supermileage/fcp-control-pcb/fcp-control-pcb/Symbols/LM311DR/LM311DR.step

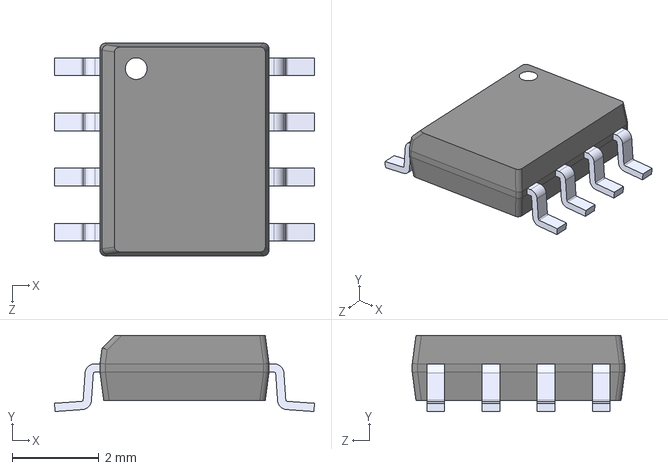
[picture p1: CAD file, 2022-12-03]
fcp-control-pcb/Symbols/LM311DR/LM311DR.step
5.99 x 1.75 x 4.90 mm
