supermileage/fcp-control-pcb/fcp-control-pcb/fcp-control-pcb.kicad_pcb

## KiCad design fcp-control-pcb/fcp-control-pcb.kicad_pcb (2023-03-18)

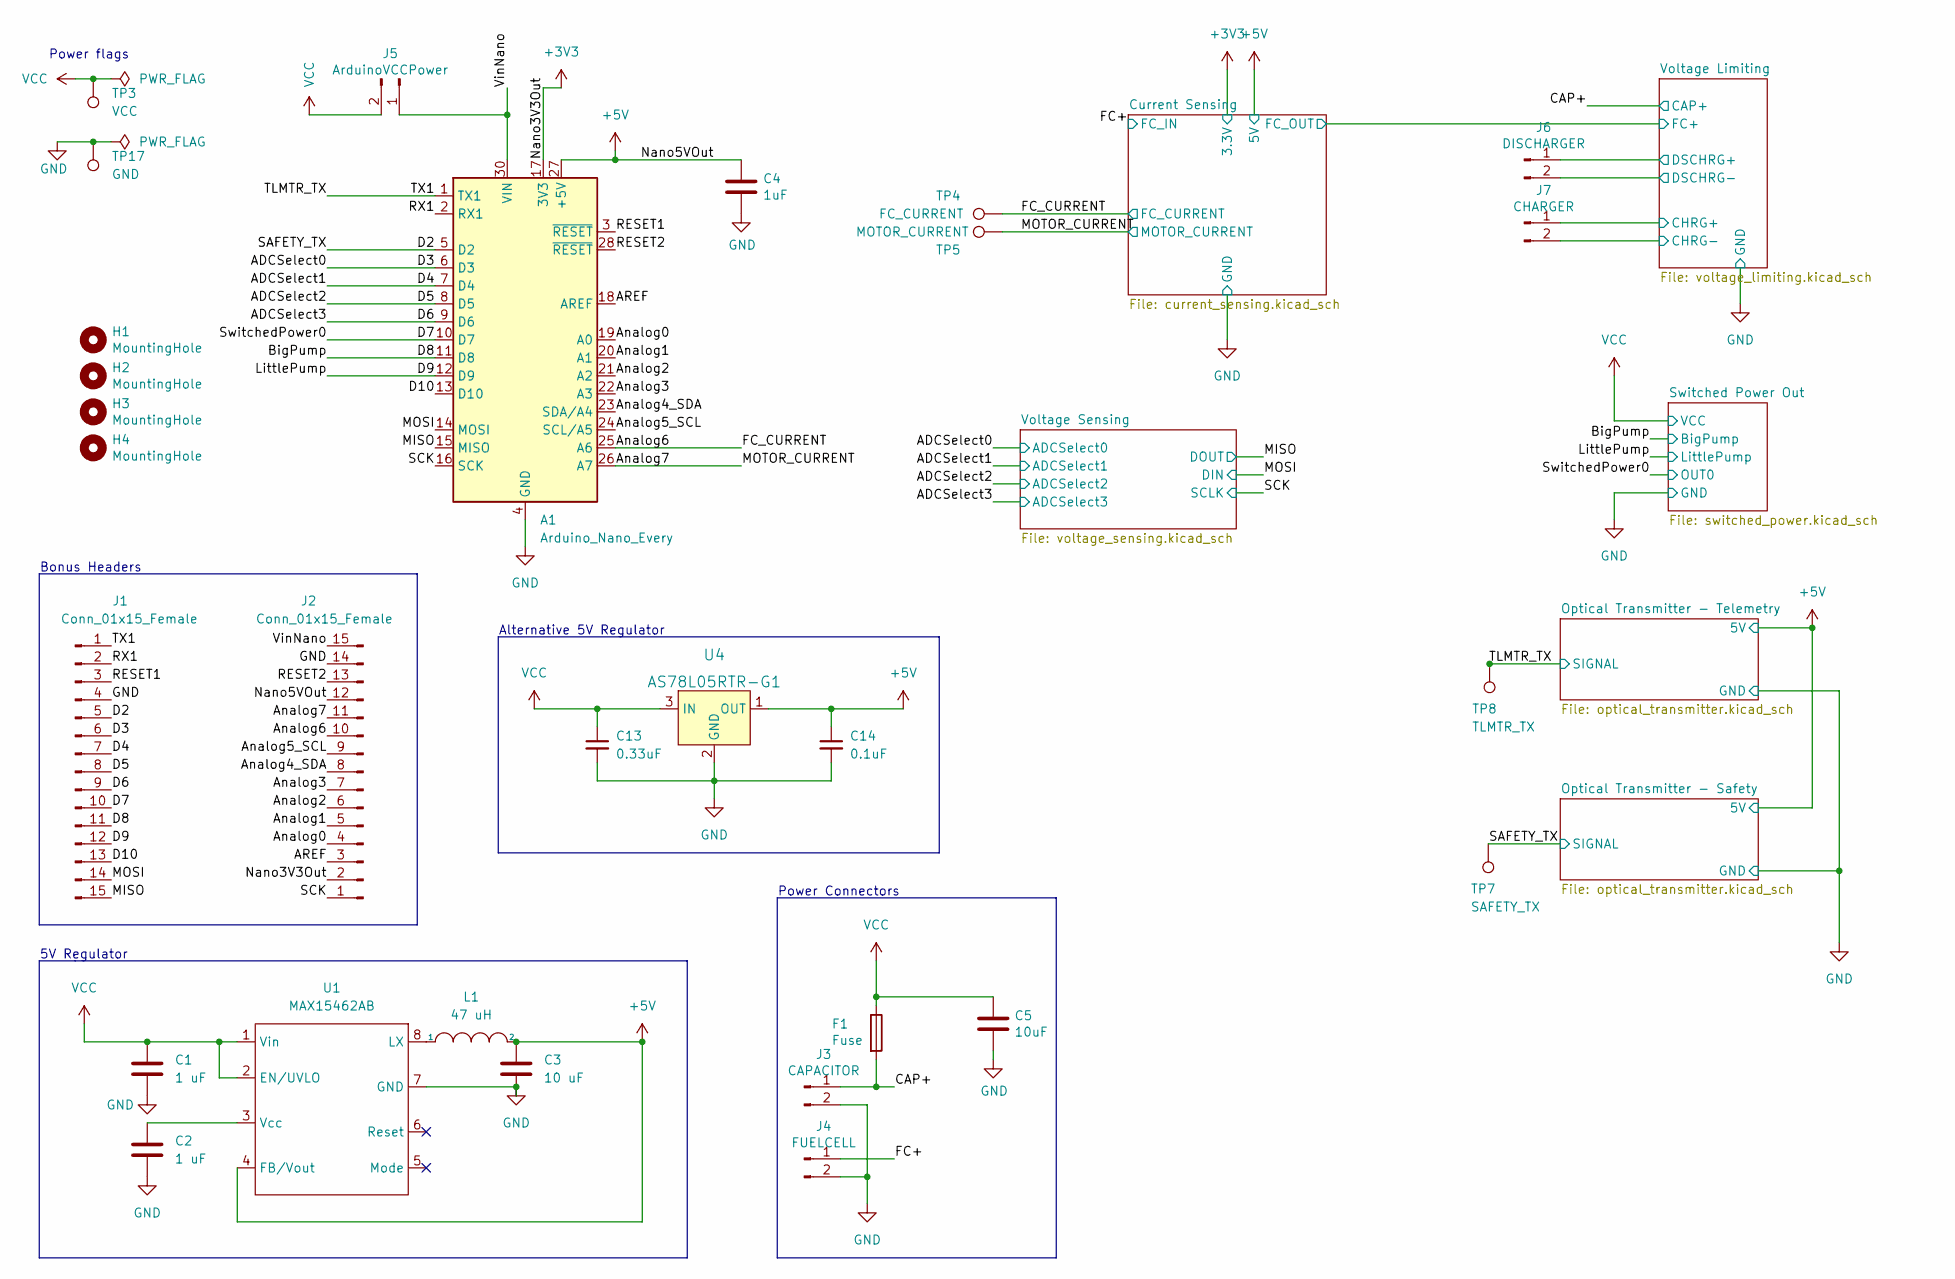
[picture p2: schematic fcp-control-pcb.kicad_sch]

Parts:
A1: Arduino_Nano_Every; Arduino_Nano
C1, C2: 1 uF; C_0805_2012Metric_Pad1.18x1.45mm_HandSolder
C3: 10 uF; C_0805_2012Metric_Pad1.18x1.45mm_HandSolder
C4: 1uF; C_0805_2012Metric_Pad1.18x1.45mm_HandSolder; DigikeyPN 490-12330-1-ND
C5: 10uF; C_0805_2012Metric_Pad1.18x1.45mm_HandSolder; DigikeyPN 490-12330-1-ND
C13: 0.33uF; C_0805_2012Metric_Pad1.18x1.45mm_HandSolder
C14: 0.1uF; C_0805_2012Metric_Pad1.18x1.45mm_HandSolder
F1: Fuse; 3586KTR; DigikeyPN 36-3586KCT-ND
H1, H2, H3, H4: MountingHole; MountingHole_3.2mm_M3
J1, J2: Conn_01x15_Female; PinSocket_1x15_P2.54mm_Vertical; MPN 310-87-115-41-001101; DigikeyPN 1212-1103-ND
J3: CAPACITOR; VP0265540000G
J4: FUELCELL; VP0265540000G; DigikeyPN VP0265540000G-ND
J5: ArduinoVCCPower; PinHeader_1x02_P2.54mm_Vertical
J6: DISCHARGER; Molex_Mini-Fit_Jr_5569-02A2_2x01_P4.20mm_Horizontal; DigikeyPN 0050361758-ND
J7: CHARGER; Molex_Mini-Fit_Jr_5569-02A2_2x01_P4.20mm_Horizontal; DigikeyPN 0050361758-ND
L1: 47 uH; L_Coilcraft_LPS4018
TP3: VCC; TestPoint_Pad_4.0x4.0mm
TP4: FC_CURRENT; TestPoint_Pad_4.0x4.0mm
TP5: MOTOR_CURRENT; TestPoint_Pad_4.0x4.0mm
TP7: SAFETY_TX; TestPoint_Pad_4.0x4.0mm
TP8: TLMTR_TX; TestPoint_Pad_4.0x4.0mm
TP17: GND; TestPoint_Pad_4.0x4.0mm
U1: MAX15462AB; TDFN-8-1EP_2x2mm_P0.5mm_EP0.8x1.2mm; digikey part no. MAX15462BATA+TCT-ND
U4: AS78L05RTR-G1; SOT-89-3_Handsoldering; MPN AS78L05RTR-G1; Digi-Key_PN AS78L05RTR-G1DITR-ND

Connections:
+3V3: A1.17 (3V3), J2.2; also elsewhere on the board
+5V: A1.27 (+5V), C3.1, C4.1, C14.1, J2.12, L1.2, U1.4 (FB/Vout), U4.1 (OUT); also elsewhere on the board
/ADCSelect0: A1.6 (D3), J1.6; also elsewhere on the board
/ADCSelect1: A1.7 (D4), J1.7; also elsewhere on the board
/ADCSelect2: A1.8 (D5), J1.8; also elsewhere on the board
/ADCSelect3: A1.9 (D6), J1.9; also elsewhere on the board
/AREF: A1.18 (AREF), J2.3
/Analog0: A1.19 (A0), J2.4
/Analog1: A1.20 (A1), J2.5
/Analog2: A1.21 (A2), J2.6
/Analog3: A1.22 (A3), J2.7
/Analog4_SDA: A1.23 (SDA/A4), J2.8
/Analog5_SCL: A1.24 (SCL/A5), J2.9
/Analog6: A1.25 (A6), J2.10, TP4.1; also elsewhere on the board
/Analog7: A1.26 (A7), J2.11, TP5.1; also elsewhere on the board
/BigPump: A1.11 (D8), J1.11; also elsewhere on the board
/CAP+: F1.2, J3.1; also elsewhere on the board
/D2: A1.5 (D2), J1.5, TP7.1; also elsewhere on the board
/D7: A1.10 (D7), J1.10; also elsewhere on the board
/D9: A1.12 (D9), J1.12; also elsewhere on the board
/D10: A1.13 (D10), J1.13
/FC+: J4.1; also elsewhere on the board
/MISO: A1.15 (MISO), J1.15; also elsewhere on the board
/MOSI: A1.14 (MOSI), J1.14; also elsewhere on the board
/RESET1: A1.3 (~RESET), J1.3
/RESET2: A1.28 (~RESET), J2.13
/RX1: A1.2 (RX1), J1.2
/SCK: A1.16 (SCK), J2.1; also elsewhere on the board
/TLMTR_TX: A1.1 (TX1), J1.1, TP8.1; also elsewhere on the board
/VinNano: A1.30 (VIN), J2.15, J5.1
/Voltage Limiting/CHRG+: J7.1; also elsewhere on the board
/Voltage Limiting/DSCHRG+: J6.1; also elsewhere on the board
GND: A1.4 (GND), A1.29 (GND), C1.2, C2.2, C3.2, C4.2, C5.2, C13.2, C14.2, J1.4, J2.14, J3.2, J4.2, J6.2, J7.2, TP17.1, U1.7 (GND), U4.2 (GND); also elsewhere on the board
unnamed: C2.1, U1.3 (Vcc)
unnamed: L1.1, U1.8 (LX)
VCC: C1.1, C5.1, C13.1, F1.1, J5.2, TP3.1, U1.1 (Vin), U1.2 (EN/UVLO), U4.3 (IN); also elsewhere on the board

Notes on the sheet:
5V Regulator
Power Connectors
Power flags
Bonus Headers
Alternative 5V Regulator

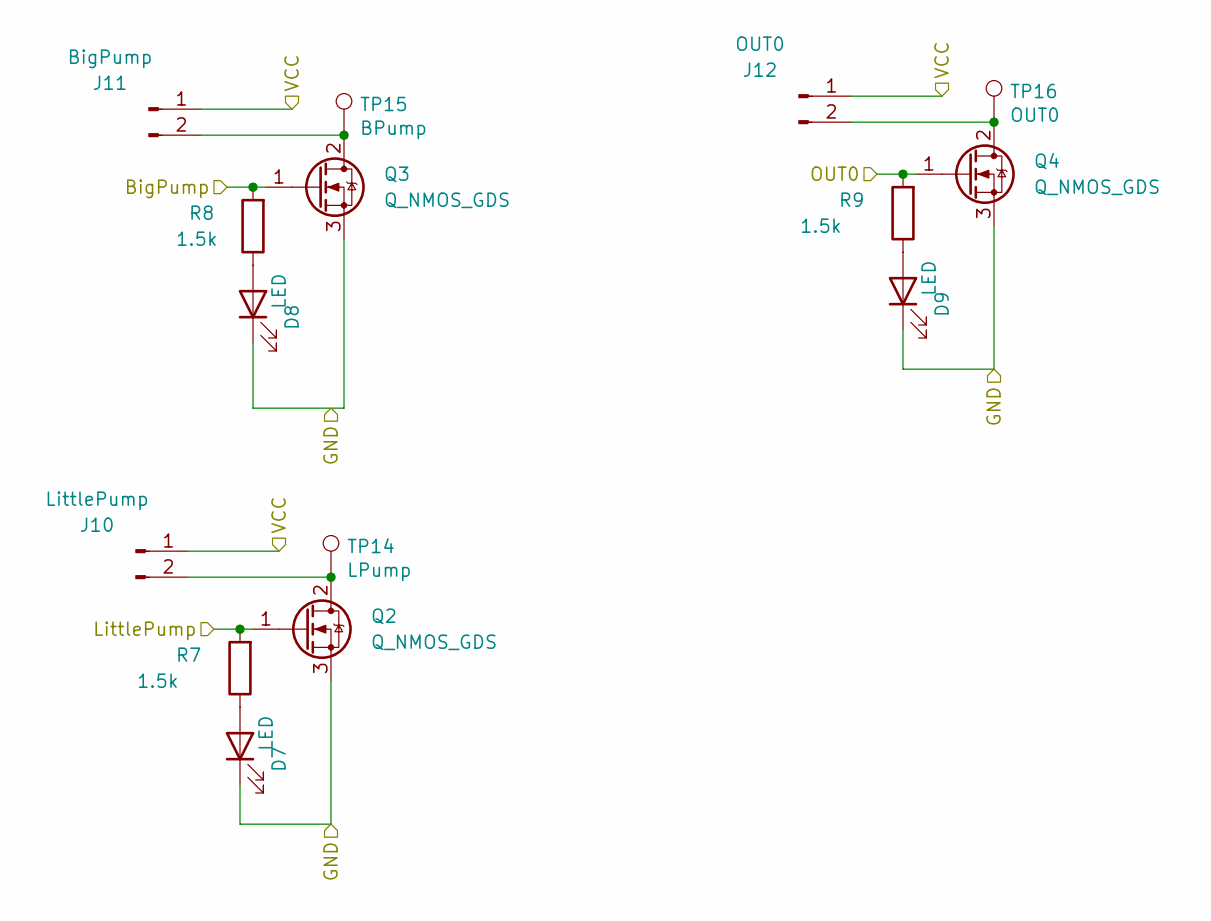
[picture p3: schematic switched_power.kicad_sch]

Parts:
D7, D8, D9: LED; LED_0603_1608Metric; DigikeyPN SML-D12W8WT86ACT-ND
J10: LittlePump; Molex_Mini-Fit_Jr_5569-02A2_2x01_P4.20mm_Horizontal; DigikeyPN 0050361758-ND
J11: BigPump; Molex_Mini-Fit_Jr_5569-02A2_2x01_P4.20mm_Horizontal; DigikeyPN 0050361758-ND
J12: OUT0; Molex_Mini-Fit_Jr_5569-02A2_2x01_P4.20mm_Horizontal; DigikeyPN 0050361758-ND
Q2, Q3, Q4: Q_NMOS_GDS; SOT-89-3_Handsoldering; DigikeyPN DMN2004WKDICT-ND
R7, R8, R9: 1.5k; R_0805_2012Metric_Pad1.20x1.40mm_HandSolder; DigikeyPN A121524CT-ND
TP14: LPump; PinSocket_1x01_P2.54mm_Vertical
TP15: BPump; PinSocket_1x01_P2.54mm_Vertical
TP16: OUT0; PinSocket_1x01_P2.54mm_Vertical

Connections:
/BigPump: Q3.1 (G), R8.2; also elsewhere on the board
/D7: Q4.1 (G), R9.2; also elsewhere on the board
/D9: Q2.1 (G), R7.2; also elsewhere on the board
GND: D7.1 (K), D8.1 (K), D9.1 (K), Q2.3 (S), Q3.3 (S), Q4.3 (S); also elsewhere on the board
unnamed: D7.2 (A), R7.1
unnamed: D8.2 (A), R8.1
unnamed: D9.2 (A), R9.1
unnamed: J10.2, Q2.2 (D), TP14.1
unnamed: J11.2, Q3.2 (D), TP15.1
unnamed: J12.2, Q4.2 (D), TP16.1
VCC: J10.1, J11.1, J12.1; also elsewhere on the board

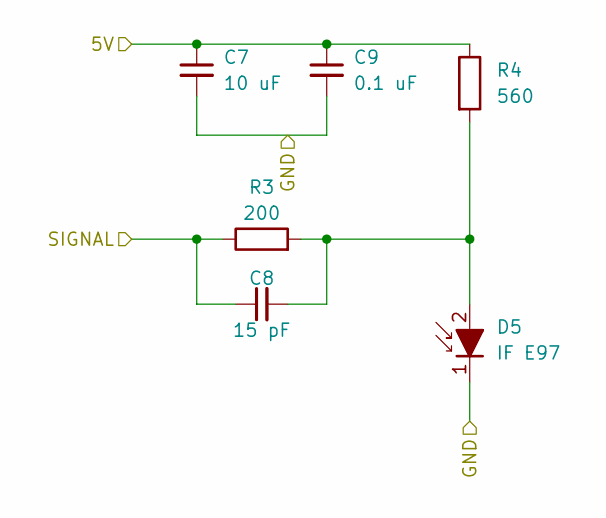
[picture p4: schematic optical_transmitter.kicad_sch]

Parts:
C7: 10 uF; C_0805_2012Metric_Pad1.18x1.45mm_HandSolder
C8: 15 pF; C_0805_2012Metric_Pad1.18x1.45mm_HandSolder
C9: 0.1 uF; C_0805_2012Metric_Pad1.18x1.45mm_HandSolder
D5: IF E97; IF-E97
R3: 200; R_0805_2012Metric_Pad1.20x1.40mm_HandSolder
R4: 560; R_0805_2012Metric_Pad1.20x1.40mm_HandSolder

Connections:
+5V: C7.1, C9.1, R4.1; also elsewhere on the board
/TLMTR_TX: C8.1, R3.1; also elsewhere on the board
GND: C7.2, C9.2, D5.1 (K); also elsewhere on the board
unnamed: C8.2, D5.2 (A), R3.2, R4.2

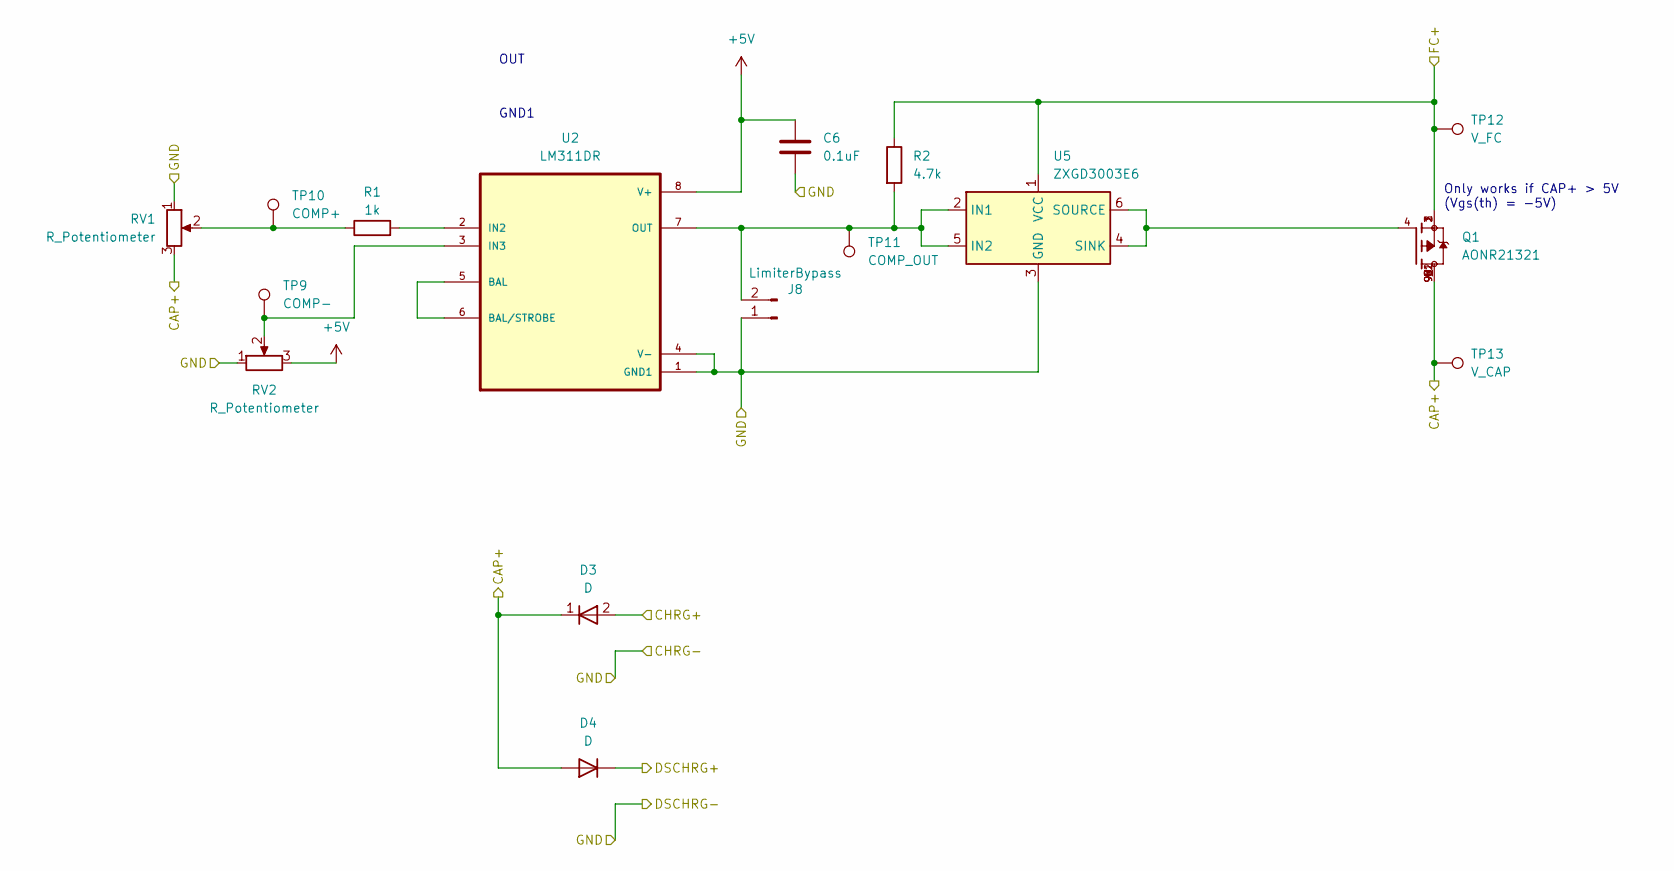
[picture p5: schematic voltage_limiting.kicad_sch]

Parts:
C6: 0.1uF; C_0805_2012Metric_Pad1.18x1.45mm_HandSolder
D3, D4: D; D_PowerDI-5
J8: LimiterBypass; PinHeader_1x02_P2.54mm_Vertical; DigikeyPN 0050361758-ND
Q1: AONR21321; TRANS_AONR21321; PARTREV 1.0
R1: 1k; R_0805_2012Metric_Pad1.20x1.40mm_HandSolder
R2: 4.7k; R_0805_2012Metric_Pad1.20x1.40mm_HandSolder
RV1, RV2: R_Potentiometer; TRIM_3361P-1-203GLF
TP9: COMP-; TestPoint_Pad_4.0x4.0mm
TP10: COMP+; TestPoint_Pad_4.0x4.0mm
TP11: COMP_OUT; TestPoint_Pad_4.0x4.0mm
TP12: V_FC; TestPoint_Pad_4.0x4.0mm
TP13: V_CAP; TestPoint_Pad_4.0x4.0mm
U2: LM311DR; SOIC127P599X175-8N
U5: ZXGD3003E6; SOT-23-6

Connections:
+5V: C6.1, RV2.3, U2.8 (V+); also elsewhere on the board
/CAP+: D3.1 (K), D4.2 (A), Q1.5, Q1.6, Q1.7, Q1.8, Q1.9, Q1.9_1, Q1.9_2, RV1.3, TP13.1; also elsewhere on the board
/Current Sensing/FC_OUT: Q1.1, Q1.2, Q1.3, R2.1, TP12.1, U5.1 (VCC); also elsewhere on the board
/Voltage Limiting/CHRG+: D3.2 (A); also elsewhere on the board
/Voltage Limiting/DSCHRG+: D4.1 (K); also elsewhere on the board
GND: C6.2, J8.1, RV1.1, RV2.1, U2.1 (GND1), U2.4 (V-), U5.3 (GND); also elsewhere on the board
unnamed: J8.2, R2.2, TP11.1, U2.7 (OUT), U5.2 (IN1), U5.5 (IN2)
unnamed: Q1.4, U5.4 (SINK), U5.6 (SOURCE)
unnamed: R1.1, RV1.2, TP10.1
unnamed: R1.2, U2.2 (IN2)
unnamed: RV2.2, TP9.1, U2.3 (IN3)
unnamed: U2.5 (BAL), U2.6 (BAL/STROBE)

Notes on the sheet:
OUT
GND1
Only works if CAP+ > 5V (Vgs(th) = -5V)

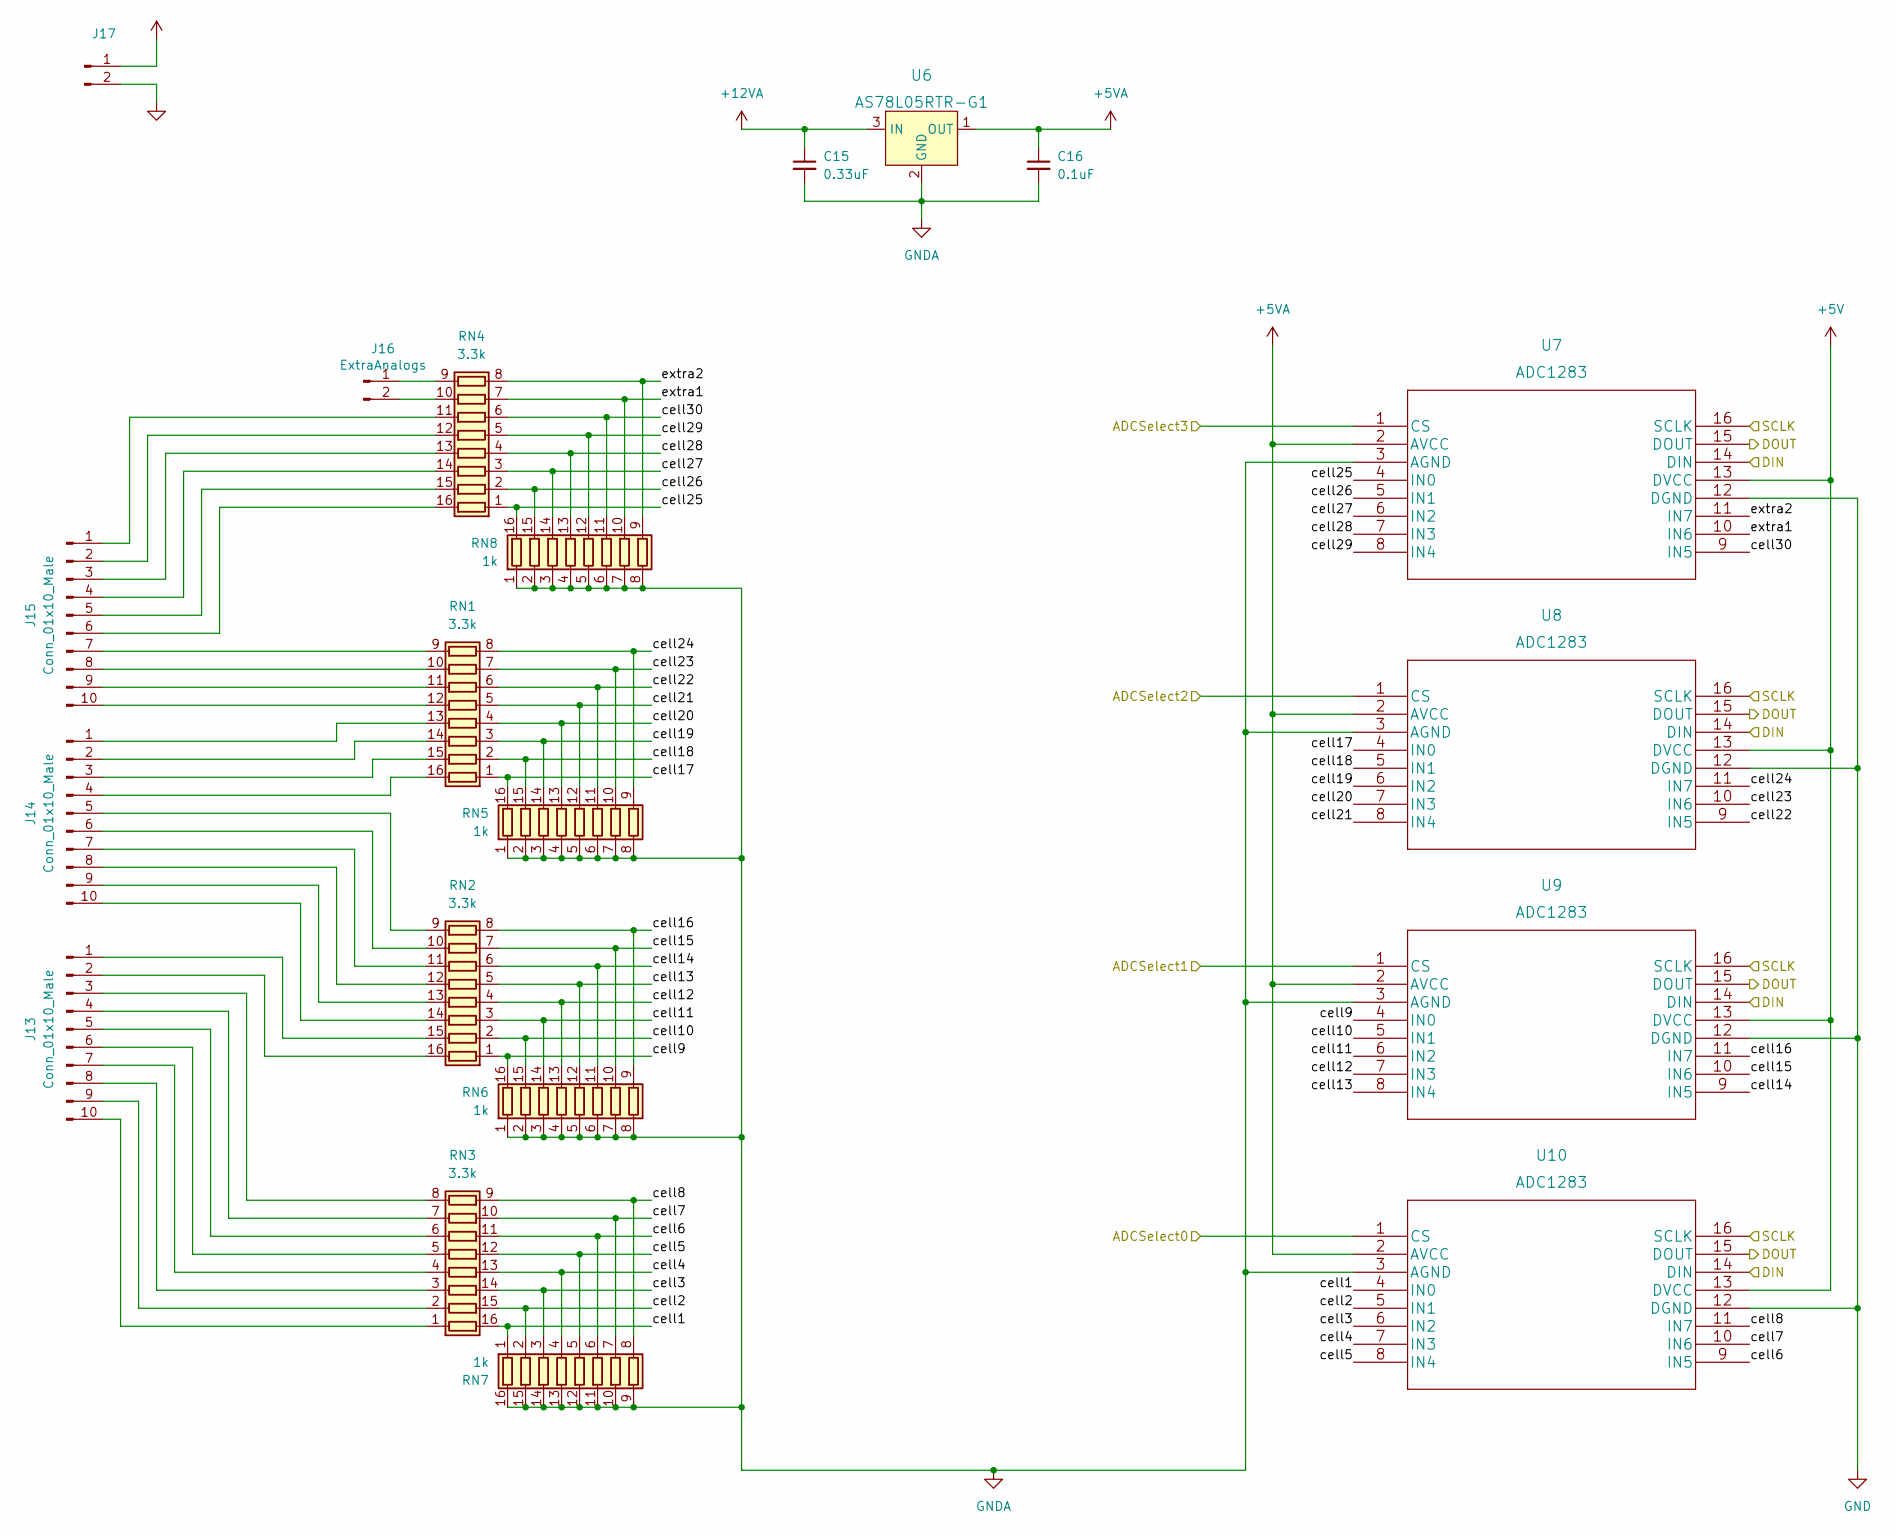
[picture p6: schematic voltage_sensing.kicad_sch]

Parts:
C15: 0.33uF; C_0805_2012Metric_Pad1.18x1.45mm_HandSolder
C16: 0.1uF; C_0805_2012Metric_Pad1.18x1.45mm_HandSolder
J13, J14, J15: Conn_01x10_Male; PhoenixContact_MCV_1,5_10-G-3.5_1x10_P3.50mm_Vertical; DigikeyPN 277-5774-ND
J16: ExtraAnalogs; PinHeader_1x02_P2.54mm_Vertical
J17: DigikeyPN 0050361758-ND
RN1, RN2, RN3, RN4: 3.3k; SOIC-16_4.55x10.3mm_P1.27mm
RN5, RN6, RN7, RN8: 1k; SOIC-16_4.55x10.3mm_P1.27mm
U6: AS78L05RTR-G1; SOT-89-3_Handsoldering; MPN AS78L05RTR-G1; Digi-Key_PN AS78L05RTR-G1DITR-ND
U7, U8, U9, U10: ADC1283; TSSOP-16_4.4x5mm_P0.65mm

Connections:
+5V: U7.13 (DVCC), U8.13 (DVCC), U9.13 (DVCC), U10.13 (DVCC); also elsewhere on the board
+5VA: C16.1, U6.1 (OUT), U7.2 (AVCC), U8.2 (AVCC), U9.2 (AVCC), U10.2 (AVCC)
/ADCSelect0: U10.1 (CS); also elsewhere on the board
/ADCSelect1: U9.1 (CS); also elsewhere on the board
/ADCSelect2: U8.1 (CS); also elsewhere on the board
/ADCSelect3: U7.1 (CS); also elsewhere on the board
/MISO: U7.15 (DOUT), U8.15 (DOUT), U9.15 (DOUT), U10.15 (DOUT); also elsewhere on the board
/MOSI: U7.14 (DIN), U8.14 (DIN), U9.14 (DIN), U10.14 (DIN); also elsewhere on the board
/SCK: U7.16 (SCLK), U8.16 (SCLK), U9.16 (SCLK), U10.16 (SCLK); also elsewhere on the board
/Voltage Sensing/cell1: RN3.16 (R1.2), RN7.1 (R1.1), U10.4 (IN0)
/Voltage Sensing/cell2: RN3.15 (R2.2), RN7.2 (R2.1), U10.5 (IN1)
/Voltage Sensing/cell3: RN3.14 (R3.2), RN7.3 (R3.1), U10.6 (IN2)
/Voltage Sensing/cell4: RN3.13 (R4.2), RN7.4 (R4.1), U10.7 (IN3)
/Voltage Sensing/cell5: RN3.12 (R5.2), RN7.5 (R5.1), U10.8 (IN4)
/Voltage Sensing/cell6: RN3.11 (R6.2), RN7.6 (R6.1), U10.9 (IN5)
/Voltage Sensing/cell7: RN3.10 (R7.2), RN7.7 (R7.1), U10.10 (IN6)
/Voltage Sensing/cell8: RN3.9 (R8.2), RN7.8 (R8.1), U10.11 (IN7)
/Voltage Sensing/cell9: RN2.1 (R1.1), RN6.16 (R1.2), U9.4 (IN0)
/Voltage Sensing/cell10: RN2.2 (R2.1), RN6.15 (R2.2), U9.5 (IN1)
/Voltage Sensing/cell11: RN2.3 (R3.1), RN6.14 (R3.2), U9.6 (IN2)
/Voltage Sensing/cell12: RN2.4 (R4.1), RN6.13 (R4.2), U9.7 (IN3)
/Voltage Sensing/cell13: RN2.5 (R5.1), RN6.12 (R5.2), U9.8 (IN4)
/Voltage Sensing/cell14: RN2.6 (R6.1), RN6.11 (R6.2), U9.9 (IN5)
/Voltage Sensing/cell15: RN2.7 (R7.1), RN6.10 (R7.2), U9.10 (IN6)
/Voltage Sensing/cell16: RN2.8 (R8.1), RN6.9 (R8.2), U9.11 (IN7)
/Voltage Sensing/cell17: RN1.1 (R1.1), RN5.16 (R1.2), U8.4 (IN0)
/Voltage Sensing/cell18: RN1.2 (R2.1), RN5.15 (R2.2), U8.5 (IN1)
/Voltage Sensing/cell19: RN1.3 (R3.1), RN5.14 (R3.2), U8.6 (IN2)
/Voltage Sensing/cell20: RN1.4 (R4.1), RN5.13 (R4.2), U8.7 (IN3)
/Voltage Sensing/cell21: RN1.5 (R5.1), RN5.12 (R5.2), U8.8 (IN4)
/Voltage Sensing/cell22: RN1.6 (R6.1), RN5.11 (R6.2), U8.9 (IN5)
/Voltage Sensing/cell23: RN1.7 (R7.1), RN5.10 (R7.2), U8.10 (IN6)
/Voltage Sensing/cell24: RN1.8 (R8.1), RN5.9 (R8.2), U8.11 (IN7)
/Voltage Sensing/cell25: RN4.1 (R1.1), RN8.16 (R1.2), U7.4 (IN0)
/Voltage Sensing/cell26: RN4.2 (R2.1), RN8.15 (R2.2), U7.5 (IN1)
/Voltage Sensing/cell27: RN4.3 (R3.1), RN8.14 (R3.2), U7.6 (IN2)
/Voltage Sensing/cell28: RN4.4 (R4.1), RN8.13 (R4.2), U7.7 (IN3)
/Voltage Sensing/cell29: RN4.5 (R5.1), RN8.12 (R5.2), U7.8 (IN4)
/Voltage Sensing/cell30: RN4.6 (R6.1), RN8.11 (R6.2), U7.9 (IN5)
/Voltage Sensing/extra1: RN4.7 (R7.1), RN8.10 (R7.2), U7.10 (IN6)
/Voltage Sensing/extra2: RN4.8 (R8.1), RN8.9 (R8.2), U7.11 (IN7)
GND: U7.12 (DGND), U8.12 (DGND), U9.12 (DGND), U10.12 (DGND); also elsewhere on the board
unnamed: J13.1, RN2.15 (R2.2)
unnamed: J13.2, RN2.16 (R1.2)
unnamed: J13.3, RN3.8 (R8.1)
unnamed: J13.4, RN3.7 (R7.1)
unnamed: J13.5, RN3.6 (R6.1)
unnamed: J13.6, RN3.5 (R5.1)
unnamed: J13.7, RN3.4 (R4.1)
unnamed: J13.8, RN3.3 (R3.1)
unnamed: J13.9, RN3.2 (R2.1)
unnamed: J13.10, RN3.1 (R1.1)
unnamed: J14.1, RN1.13 (R4.2)
unnamed: J14.2, RN1.14 (R3.2)
unnamed: J14.3, RN1.15 (R2.2)
unnamed: J14.4, RN1.16 (R1.2)
unnamed: J14.5, RN2.9 (R8.2)
unnamed: J14.6, RN2.10 (R7.2)
unnamed: J14.7, RN2.11 (R6.2)
unnamed: J14.8, RN2.12 (R5.2)
unnamed: J14.9, RN2.13 (R4.2)
unnamed: J14.10, RN2.14 (R3.2)
unnamed: J15.1, RN4.11 (R6.2)
unnamed: J15.2, RN4.12 (R5.2)
unnamed: J15.3, RN4.13 (R4.2)
unnamed: J15.4, RN4.14 (R3.2)
unnamed: J15.5, RN4.15 (R2.2)
unnamed: J15.6, RN4.16 (R1.2)
unnamed: J15.7, RN1.9 (R8.2)
unnamed: J15.8, RN1.10 (R7.2)
unnamed: J15.9, RN1.11 (R6.2)
unnamed: J15.10, RN1.12 (R5.2)
unnamed: J16.1, RN4.9 (R8.2)
unnamed: J16.2, RN4.10 (R7.2)

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
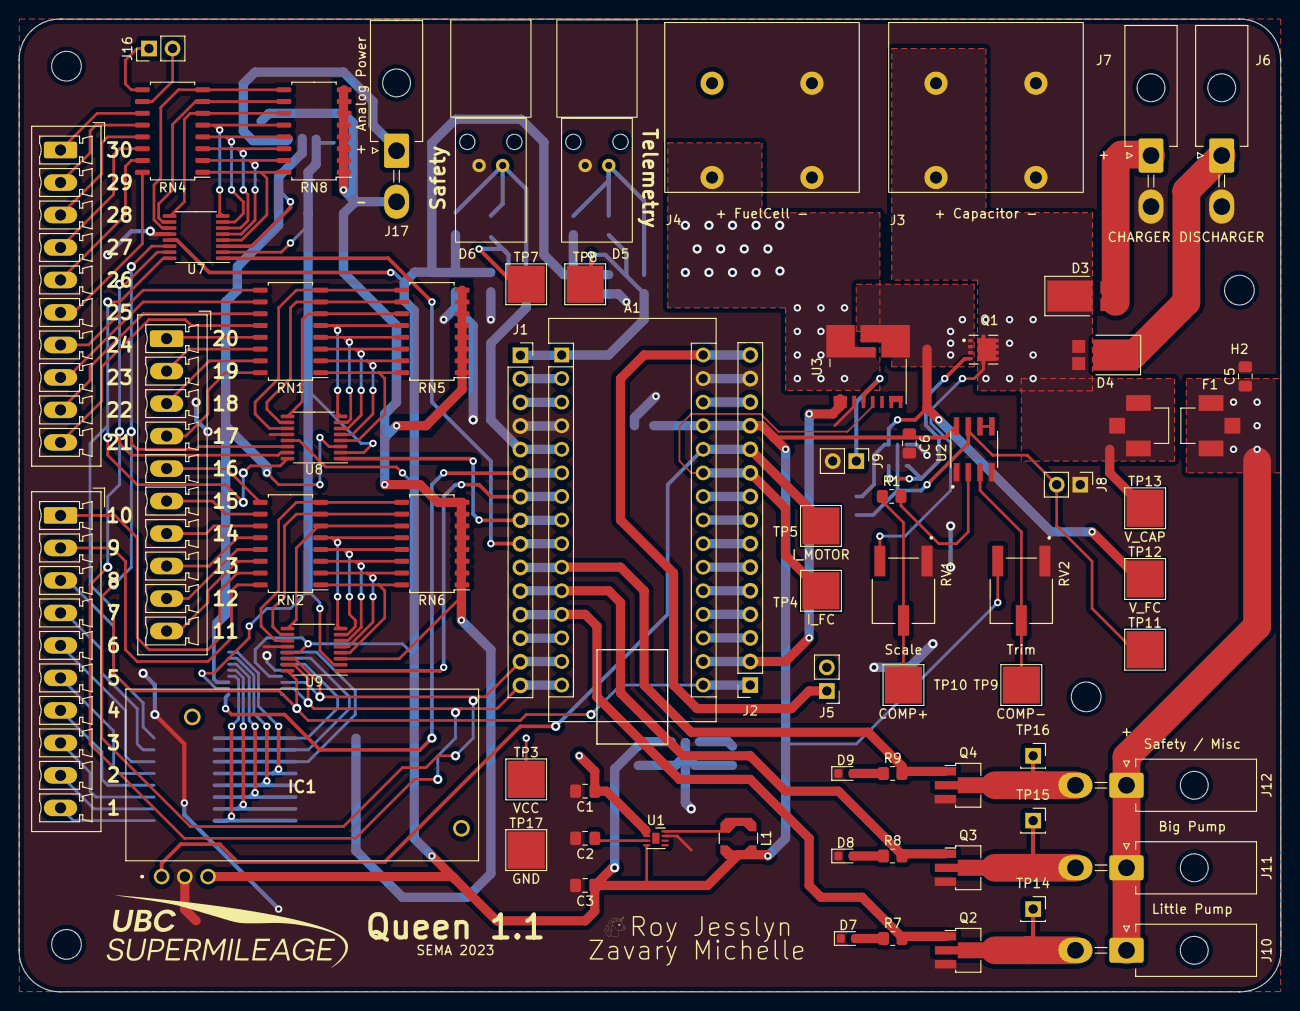
[picture p7: board fcp-control-pcb.kicad_pcb from above]

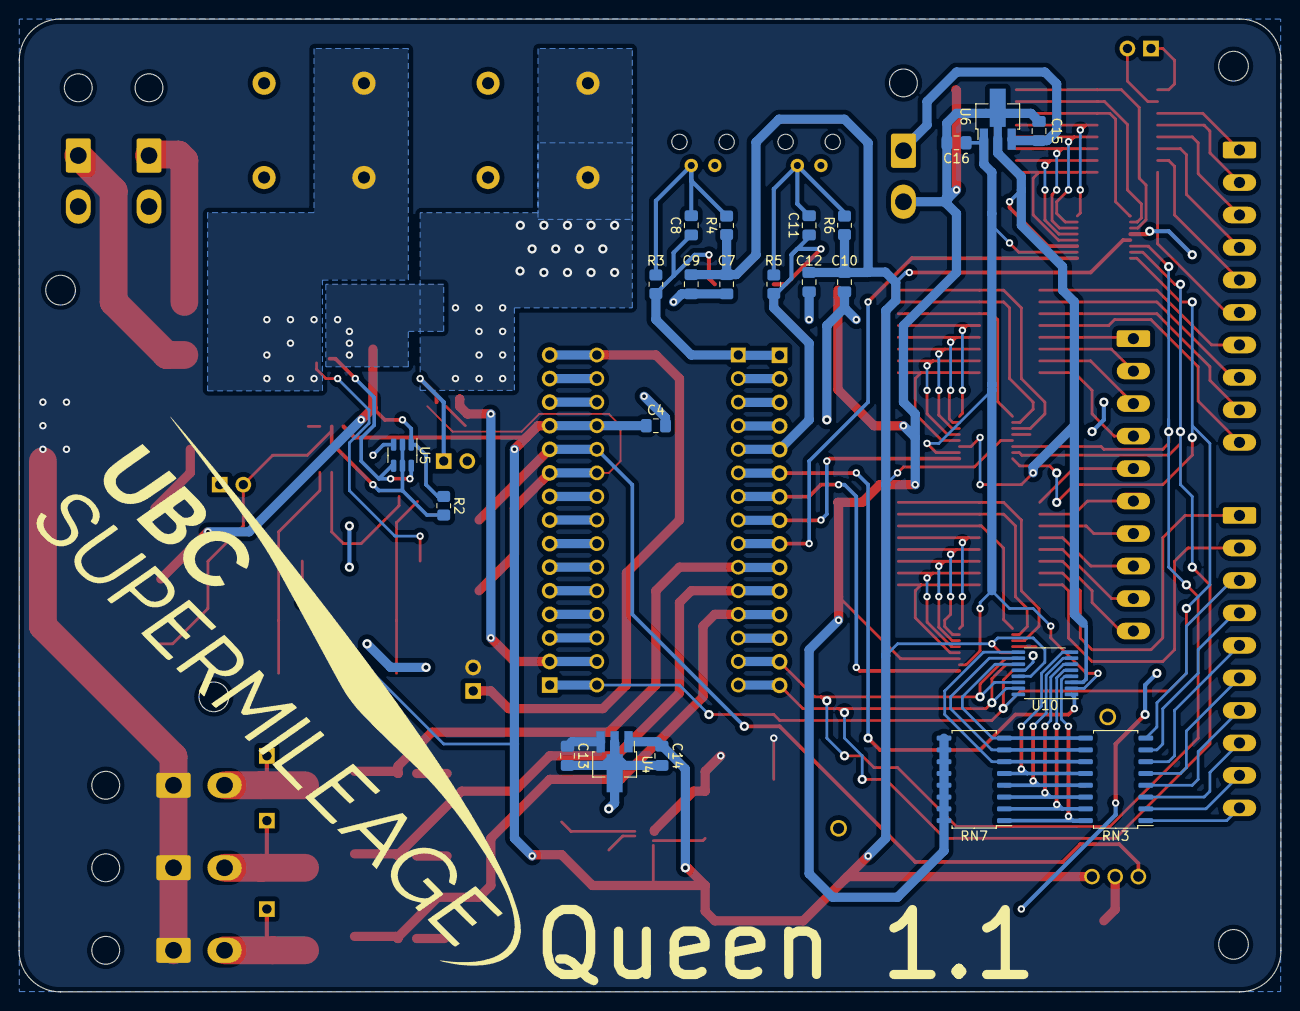
[picture p8: board fcp-control-pcb.kicad_pcb from below]

Board: 2 copper layers, 136.0 x 104.8 mm, 95 parts (22 on the bottom side), 119 nets.

Other parts of the board:
C10: 10 uF; C_0805_2012Metric_Pad1.18x1.45mm_HandSolder
C11: 15 pF; C_0805_2012Metric_Pad1.18x1.45mm_HandSolder
C12: 0.1 uF; C_0805_2012Metric_Pad1.18x1.45mm_HandSolder
D6: IF E97; IF-E97
IC1: L01Z050S05
J9: Current_Mode; PinHeader_1x02_P2.54mm_Vertical
R5: 200; R_0805_2012Metric_Pad1.20x1.40mm_HandSolder
R6: 560; R_0805_2012Metric_Pad1.20x1.40mm_HandSolder
U3: TLI4971-A050T5-U-E0001; Infineon_PG-TISON-8-5

Their connections:
+3V3: U3.1 (VDD); also elsewhere on the board
+5V: C10.1, C12.1, IC1.3 (+VCC_(+5V)), R6.1; also elsewhere on the board
/Analog6: U3.4 (Aout); also elsewhere on the board
/Analog7: IC1.1 (VOUT); also elsewhere on the board
/Current Sensing/FC_OUT: U3.7 (IP-); also elsewhere on the board
/D2: C11.1, R5.1; also elsewhere on the board
/FC+: U3.8 (IP+); also elsewhere on the board
GND: C10.2, C12.2, D6.1 (K), IC1.2 (GND), J9.2, U3.2 (GND); also elsewhere on the board
unnamed: C11.2, D6.2 (A), R5.2, R6.2
unnamed: J9.1, U3.3 (VREF)
