supermileage/fcp-control-pcb/(commit log)

2022-12-03 Design without voltage monitoring
    [LM311DR.step, current_sensing.kicad_sch, fcp-control-pcb.kicad_pcb, fcp-control-pcb.kicad_sch, optical_transmitter.kicad_sch, switched_power.kicad_sch, voltage_limiting.kicad_sch]
2023-01-12 pcb sans design review
    [LM311DR.step, current_sensing.kicad_sch, fcp-control-pcb.kicad_pcb, fcp-control-pcb.kicad_sch, optical_transmitter.kicad_sch, switched_power.kicad_sch, voltage_limiting.kicad_sch, voltage_sensing.kicad_sch]
2023-01-12 adds vias to fcc fuse
    [LM311DR.step, fcp-control-pcb.kicad_pcb]
2023-01-12 layout changes
    [fcp-control-pcb.kicad_pcb]
2023-01-14 adds enable pin control to multiplexers
    [fcp-control-pcb.kicad_pcb]
2023-01-14 fixed overlapping silkscreen
    [fcp-control-pcb.kicad_pcb]
2023-02-27 queen r1.1
    [fcp-control-pcb-B_Cu.gbl, fcp-control-pcb-B_Mask.gbs, fcp-control-pcb-B_Paste.gbp, fcp-control-pcb-B_Silkscreen.gbo, fcp-control-pcb-Edge_Cuts.gm1, fcp-control-pcb-F_Cu.gtl, fcp-control-pcb-F_Mask.gts, fcp-control-pcb-F_Paste.gtp]
2023-02-27 resize board
    [fcp-control-pcb.kicad_pcb]
2023-02-27 label tps
    [fcp-control-pcb.kicad_pcb]
2023-03-04 updated schematic and pcb for queen 1.1
2023-03-04 Fixed autosave issues
    [fcp-control-pcb.kicad_sch, voltage_limiting.kicad_sch, voltage_sensing.kicad_sch]
2023-03-18 Queen 1.1
    [fcp-control-pcb-B_Cu.gbl, fcp-control-pcb-B_Mask.gbs, fcp-control-pcb-B_Paste.gbp, fcp-control-pcb-B_Silkscreen.gbo, fcp-control-pcb-Edge_Cuts.gm1, fcp-control-pcb-F_Cu.gtl, fcp-control-pcb-F_Mask.gts, fcp-control-pcb-F_Paste.gtp]
2023-03-19 git pull new schematic
